cameronhotchkies/Sputterizer/README.md

# Sputterizer
Signal Generator for Eurorack Synthesizers
https://www.greenfacelabs.com/
