cameronhotchkies/Sputterizer/main_board/Bom_DK.xlsx

Manufacturer Part Number | Manufacturer | Digi-Key Part Number | Customer Reference | Reference Designator | Packaging | Part Status | Quantity | Unit Price | Extended Price | Quantity Available | Mfg Std Lead Time | Description | RoHS Status | Lead Free Status | REACH Status
A000005 | Arduino | 1050-1001-ND |  | A1 | Box | Active | 1 | 22 | $22.00 | 850 | Not Available | ARDUINO NANO ATMEGA328 EVAL BRD | RoHS Compliant | Lead free | Not Available
SR215C104KAA | AVX Corporation | 478-2472-ND |  | C2 C4 C5 | Bulk | Active | 3 | 0.2 | $0.60 | 35294 | 11 Weeks | CAP CER 0.1UF 50V X7R RADIAL | ROHS3 Compliant | Lead free | REACH Unaffected
25ML100MEFC8X7 | Rubycon | 1189-3982-ND |  | C6 C1 C3 | Bulk | Active | 3 | 0.29 | $0.87 | 6266 | 17 Weeks | CAP ALUM 100UF 20% 25V RADIAL | ROHS3 Compliant | Lead free | REACH Unaffected
R82EC2100DQ50J | KEMET | 399-5450-1-ND |  | C7 | Cut Tape (CT) | Active | 1 | 0.27 | $0.27 | 49575 | Not Available | CAP FILM 10000PF 5% 100VDC RAD | ROHS3 Compliant | Lead free | REACH Unaffected
R82DC3100DQ50J | KEMET | 399-5444-1-ND |  | C9 C8 | Cut Tape (CT) | Active | 2 | 0.31 | $0.62 | 86862 | Not Available | CAP FILM 0.1UF 5% 63VDC RADIAL | ROHS3 Compliant | Lead free | REACH Unaffected
1N4148-TP | Micro Commercial Co | 1N4148-TPMSCT-ND |  | D1 D2 D3 D4 | Cut Tape (CT) | Active | 4 | 0.1 | $0.40 | 127158 | 14 Weeks | DIODE GEN PURP 75V 150MA DO35 | ROHS3 Compliant | Lead free | REACH Unaffected
1N4148-TP | Micro Commercial Co | 1N4148-TPMSCT-ND |  | D6 D5 | Cut Tape (CT) | Active | 2 | 0.1 | $0.20 | 127158 | 14 Weeks | DIODE GEN PURP 75V 150MA DO35 | ROHS3 Compliant | Lead free | REACH Unaffected
151031SS04000 | Wurth Electronics Inc. | 732-5005-ND |  | D7 | Bulk | Active | 1 | 0.17 | $0.17 | 145 | 11 Weeks | LED RED DIFFUSED 3MM ROUND T/H | ROHS3 Compliant | Lead free | REACH Unaffected
SJ1-3535 | CUI Devices | CP1-3535-ND |  | J1 J2 J3 | Tray | Active | 3 | 1.62 | $4.86 | 3436 | 6 Weeks | CONN JACK STEREO 3.5MM R/A | RoHS Compliant | Lead free | Not Available
PRPC008DAAN-RC | Sullins Connector Solutions | S2011EC-08-ND |  | J4 | Bag | Active | 1 | 0.46 | $0.46 | 976 | Not Available | CONN HEADER VERT 16POS 2.54MM | ROHS3 Compliant | Lead free | REACH Unaffected
67997-210HLF | Amphenol ICC (FCI) | 609-3236-ND |  | J5 | Bag | Active | 1 | 0.54 | $0.54 | 3868 | 7 Weeks | CONN HEADER VERT 10POS 2.54MM | RoHS Compliant | Lead free | Not Available
M20-9990245 | Harwin Inc. | 952-2261-ND |  | JP1 JP2 JP3 | Bulk | Active | 3 | 0.15 | $0.45 | 36078 | 10 Weeks | CONN HEADER VERT 2POS 2.54MM | ROHS3 Compliant | Lead free | REACH Unaffected
BS170-D75Z | ON Semiconductor | BS170-D75ZCT-ND |  | Q1 | Cut Tape (CT) | Active | 1 | 0.4 | $0.40 | 5612 | 7 Weeks | MOSFET N-CH 60V 500MA TO-92 | ROHS3 Compliant | Lead free | REACH Unaffected
CF14JT470R | Stackpole Electronics Inc | CF14JT470RCT-ND |  | R1 | Cut Tape (CT) | Active | 1 | 0.1 | $0.10 | 174664 | 15 Weeks | RES 470 OHM 1/4W 5% AXIAL | ROHS3 Compliant | Lead free | REACH Unaffected
MRS25000C1002FCT00 | Vishay BC Components | BC3326CT-ND |  | R10 R9 | Cut Tape (CT) | Active | 2 | 0.29 | $0.58 | 6522 | 14 Weeks | RES 10K OHM 0.6W 1% AXIAL | ROHS3 Compliant | Lead free | Not Available
CF14JT470R | Stackpole Electronics Inc | CF14JT470RCT-ND |  | R2 R3 | Cut Tape (CT) | Active | 2 | 0.1 | $0.20 | 174664 | 15 Weeks | RES 470 OHM 1/4W 5% AXIAL | ROHS3 Compliant | Lead free | REACH Unaffected
MRS25000C1782FCT00 | Vishay BC Components | BC4022CT-ND |  | R4 | Cut Tape (CT) | Discontinued at Digi-Key | 1 | 0.29 | $0.29 | 4129 | Not Available | RES 17.8K OHM 0.6W 1% AXIAL | ROHS3 Compliant | Lead free | Not Available
MRS25000C1403FCT00 | Vishay BC Components | BC3995CT-ND |  | R5 | Cut Tape (CT) | Active | 1 | 0.29 | $0.29 | 3344 | 14 Weeks | RES 140K OHM 0.6W 1% AXIAL | ROHS3 Compliant | Lead free | Not Available
MRS25000C1582FCT00 | Vishay BC Components | BC4574CT-ND |  | R6 | Cut Tape (CT) | Active | 1 | 0.29 | $0.29 | 3644 | 14 Weeks | RES 15.8K OHM 1% 0.6W AXIAL | ROHS3 Compliant | Lead free | Not Available
CF14JT1K00 | Stackpole Electronics Inc | CF14JT1K00CT-ND |  | R7 | Cut Tape (CT) | Active | 1 | 0.1 | $0.10 | 634886 | 15 Weeks | RES 1K OHM 1/4W 5% AXIAL | ROHS3 Compliant | Lead free | REACH Unaffected
CF14JT10K0 | Stackpole Electronics Inc | CF14JT10K0CT-ND |  | R8 | Cut Tape (CT) | Active | 1 | 0.1 | $0.10 | 522197 | 15 Weeks | RES 10K OHM 1/4W 5% AXIAL | ROHS3 Compliant | Lead free | REACH Unaffected
PTD901-1015K-B103 | Bourns Inc. | PTD901-1015K-B103-ND |  | RV1 RV2 RV3 | Tray | Active | 3 | 1.68 | $5.04 | 1041 | 15 Weeks | POT 10K OHM 1/20W CARBON LINEAR | ROHS3 Compliant | Lead free | REACH Unaffected
5006 | Keystone Electronics | 36-5006-ND |  | TP1 | Bulk | Active | 1 | 0.35 | $0.35 | 108660 | 6 Weeks | PC TEST POINT COMPACT BLACK | ROHS3 Compliant | Lead free | REACH Unaffected
SA5532AP | Texas Instruments | 296-16995-5-ND |  | U1 U2 | Tube | Active | 2 | 0.94 | $1.88 | 392 | 6 Weeks | IC OPAMP GP 2 CIRCUIT 8DIP | ROHS3 Compliant | Lead free | REACH Unaffected
CD4013BE | Texas Instruments | 296-2033-5-ND |  | U3 | Tube | Active | 1 | 0.5 | $0.50 | 41960 | 6 Weeks | IC FF D-TYPE DUAL 1BIT 14DIP | ROHS3 Compliant | Lead free | REACH Unaffected
MC78L05BP-AP | Micro Commercial Co | MC78L05BP-APMSCT-ND |  | U4 | Cut Tape (CT) | Active | 1 | 0.42 | $0.42 | 8264 | 14 Weeks | IC REG LINEAR 5V 100MA TO92 | ROHS3 Compliant | Lead free | REACH Unaffected
AR 08 HZL-TT | Assmann WSW Components | AE10011-ND |  | K1 K2 | Tube | Active | 2 | 0.5 | $1.00 | 29133 | 20 Weeks | CONN IC DIP SOCKET 8POS TIN | ROHS3 Compliant | Lead free | REACH Unaffected
AR 14 HZL-TT | Assmann WSW Components | AE10012-ND |  | K3 | Tube | Active | 1 | 0.79 | $0.79 | 3516 | 20 Weeks | CONN IC DIP SOCKET 14POS TIN | ROHS3 Compliant | Lead free | REACH Unaffected
