cameronhotchkies/Sputterizer/main_board/Bom_mouser.xlsx

Manufacturer Part Number | Manufacturer | Customer Reference | Reference Designator | Quantity | Digi-Key Part Number
A000005 | Arduino | Arduino_Nano_v3.x | A1 | 1 | 1050-1001-ND
SR215C104KAA | AVX Corporation | 100nF | C2 C4 C5 | 3
EKRG350ELL101MH09D | United Chemi-Con (UCC) | 100uF | C6 C1 C3 | 3 | 1189-3982-ND
R82EC2100DQ50J | KEMET | 10nF | C7 | 1
R82DC3100DQ50J | KEMET | 100nF | C9 C8 | 2
SB120-T | Diodes Incorporated | SB120 | D1 D2 D3 D4 | 4
1N4448 | ON Semiconductor | 1N4448 | D5 D6 | 2
151031VS06000 | Wurth Electronics Inc. | GREEN LED | D7 | 1
SJ1-3535 | CUI Devices | SJ1-3535 | J1 J2 J3 | 3
649-77313-418-16LF | Amphenol ICC (FCI) | 2X8 Header | J4 | 1
67997-210HLF | Amphenol ICC (FCI) | Conn_02x05_Odd_Even | J5 | 1
M20-9990245 | Harwin Inc. | Conn_01x02_Male | JP1 JP2 JP3 | 3
BS170-D75Z | ON Semiconductor | BS170 | Q1 | 1
CFR-25JR-52-10K | Yaego | 10K | R1 | 1
MRS25000C1002FCT00 | Vishay BC Components | 10.0K | R10 R9 | 2
CFR-25JT-52-470R | Yaego | 470 | R2 R3 | 2
MFR-25FBF52-17K8 | Yaego | 17.8K | R4 | 1
MRS25000C1403FCT00 | Vishay BC Components | 140K | R5 | 1
MFR-25FBF52-15K8 | Yaego | 15.8K | R6 | 1
CFR-25JB-1K0 | Yaego | 1K | R7 | 1
CFR-25JT-52-20K | Yaego | 20K | R8 | 1
PTD901-1015K-B103 | Bourns Inc. | 10K | RV1 RV2 RV3 | 3
5006 | Keystone Electronics | TestPoint | TP1 | 1 | 36-5006-ND
SA5532AP | Texas Instruments | NE5532 | U1 U2 | 2
CD4013BE | Texas Instruments | CD4013BE | U3 | 1
MC78L05BP-AP | Micro Commercial Co | L78L05_TO92 | U4 | 1
110-47-308-41-001000 | Mill-Max | CONN IC DIP SOCKET 8POS TIN | K1 K2 | 2
110-47-314-41-001000 | Mill-Max | CONN IC DIP SOCKET 14POS TIN | K3 | 1
K103M15X7RF53L2 | Vishay BC Components | .01uF | SC1 SC2 | 2
ECE-A1EKA470I | Panasonic Electronic Components | 47uF | SC4 | 1
SR215C104KAA | AVX Corporation | .1uF | SC5 SC3 | 2
151031SS04000 | Wurth Electronics Inc. | Red LED | SD1 SD2 SD3 SD4 SD5 SD6 SD7 SD8 SD9 SD10 SD11 SD12 | 12
67997-210HLF | Amphenol ICC (FCI) | Conn_02x05_Odd_Even | SJ1 | 1
CFR-25JB-1K0 | Yaego | 1K | SR7 | 1
CFR-25JR-52-10K | Yaego | 10K | SR3 SR5 SR1 SR2 | 4
CFR-25JT-52-2K2 | Yaego | 2.2K | SR4 SR6 | 2
PEC11R-4315F-S0012 | Bourns Inc. | PEC11R | SSW1 | 1
TLC5916IN | Texas Instruments | TLC5916 | SU1 SU2 | 2
110-47-316-41-001000 | Mill-Max | CONN IC DIP SOCKET 16POS TIN | SK1 SK2 | 2
IDSD-05-D-03.00-T | Samtec | Cable | SCB1 | 1
HCSD-08-D-12.00-01-N-G | Samtec | 16 Pos Cable | SCB2
971070155 | Wurth Electronics Inc. |  | SA1 SA2 SA3 SA4 | 4
4687 | Keystone Electronics |  | SB1 SB2 SB3 SB4 | 4
29331 | Keystone Electronics |  | SC1 SC2 SC3 SC4 | 4
705820060 | Wurth Electronics Inc. | LED Standoff 6mm | SL1 SL2 SL3 SL4 SL5 SL6 SL7 SL8 SL9 SL10 SL11 SL12 | 12
1221-L | Davies Moulding | Knob | KN1 KN2 KN3 KN4 | 4
450-CK1560 | Eagle Plastic Devices | Knob | KN5 | 1
