cameronhotchkies/Sputterizer/main_board/sputterizer.xlsx

Reference | Quantity | Value | Digi-Key Part
A1 | 1 | Arduino_Nano_v3.x | 1050-1001-ND
C2 C4 C5 | 3 | 100nF | 478-2472-ND
C6 C1 C3 | 3 | 100uF | 1189-3982-ND
C7 | 1 | 10nF | 399-5450-1-ND
C9 C8 | 2 | 100nF | 399-5444-1-ND
D1 D2 D3 D4 | 4 | SB120 | 1N4148-TPMSCT-ND
D5 D6 | 2 | 1N4148 | 1N4148VSCT-ND
D7 | 1 | LED | 732-5005-ND
J1 J2 J3 | 3 | SJ1-3535 | CP1-3535-ND
J4 | 1 | 2X8 Header | S2011EC-08-ND
J5 | 1 | Conn_02x05_Odd_Even | 609-3236-ND
JP1 JP2 JP3 | 3 | Conn_01x02_Male | 952-2261-ND
Q1 | 1 | BS170 | BS170-D75ZCT-ND
R1 | 1 | 10K | CF14JT10K0CT-ND
R10 R9 | 2 | 10.0K | BC3326CT-ND
R2 R3 | 2 | 470 | CF14JT470RCT-ND
R4 | 1 | 17.8K | PPC17.8KXCT-ND
R5 | 1 | 140K | BC3995CT-ND
R6 | 1 | 15.8K | BC4574CT-ND
R7 | 1 | 1K | CF14JT1K00CT-ND
R8 | 1 | 20K | CF14JT20K0CT-ND
RV1 RV2 RV3 | 3 | 10K | PTD901-1015K-B103-ND
TP1 | 1 | TestPoint | 36-5006-ND
U1 U2 | 2 | NE5532 | 296-16995-5-ND
U3 | 1 | CD4013BE | 296-2033-5-ND
U4 | 1 | L78L05_TO92 | MC78L05BP-APMSCT-ND
K1 K2 | 2 | CONN IC DIP SOCKET 8POS TIN | AE10011-ND
K3 | 1 | CONN IC DIP SOCKET 14POS TIN | AE10012-ND
SC1 SC2 | 2 | .01uF | BC5136-ND
SC4 | 1 | 47uF | P19582CT-ND
SC5 SC3 | 2 | .1uF | 478-2472-ND
SD1 SD2 SD3 SD4 SD5 SD6 SD7 SD8 SD9 SD10 SD11 SD12 | 12 | Red LED | 732-5005-ND
SJ1 | 1 | Conn_02x05_Odd_Even | 609-3236-ND
SR3 SR5 SR1 SR2 | 4 | 10K | CF14JT10K0CT-ND
SR4 SR6 | 2 | 2K | CF14JT2K20CT-ND
SSW1 | 1 | PEC11R | PEC11R-4315F-S0012-ND
SU1 SU2 | 2 | TLC5916 | 296-24383-5-ND
SCB1 | 1 | Cable | 3M156030-MC10G-3M156030-3-ND
SA1 SA2 SA3 SA4 | 4 |  | 732-13045-ND
SB1 SB2 SB3 SB4 | 4 |  | 36-4687-ND
SC1 SC2 SC3 SC4 | 4 |  | 36-29331-ND
SL1 SL2 SL3 SL4 SL5 SL6 SL7 SL8 SL9 SL10 SL11 SL12 | 12 |  | RPC4260-ND
SK1 | 1 | Knob | 226-4215-ND
