cameronhotchkies/Sputterizer/main_board/sputterizer/schematic.pdf

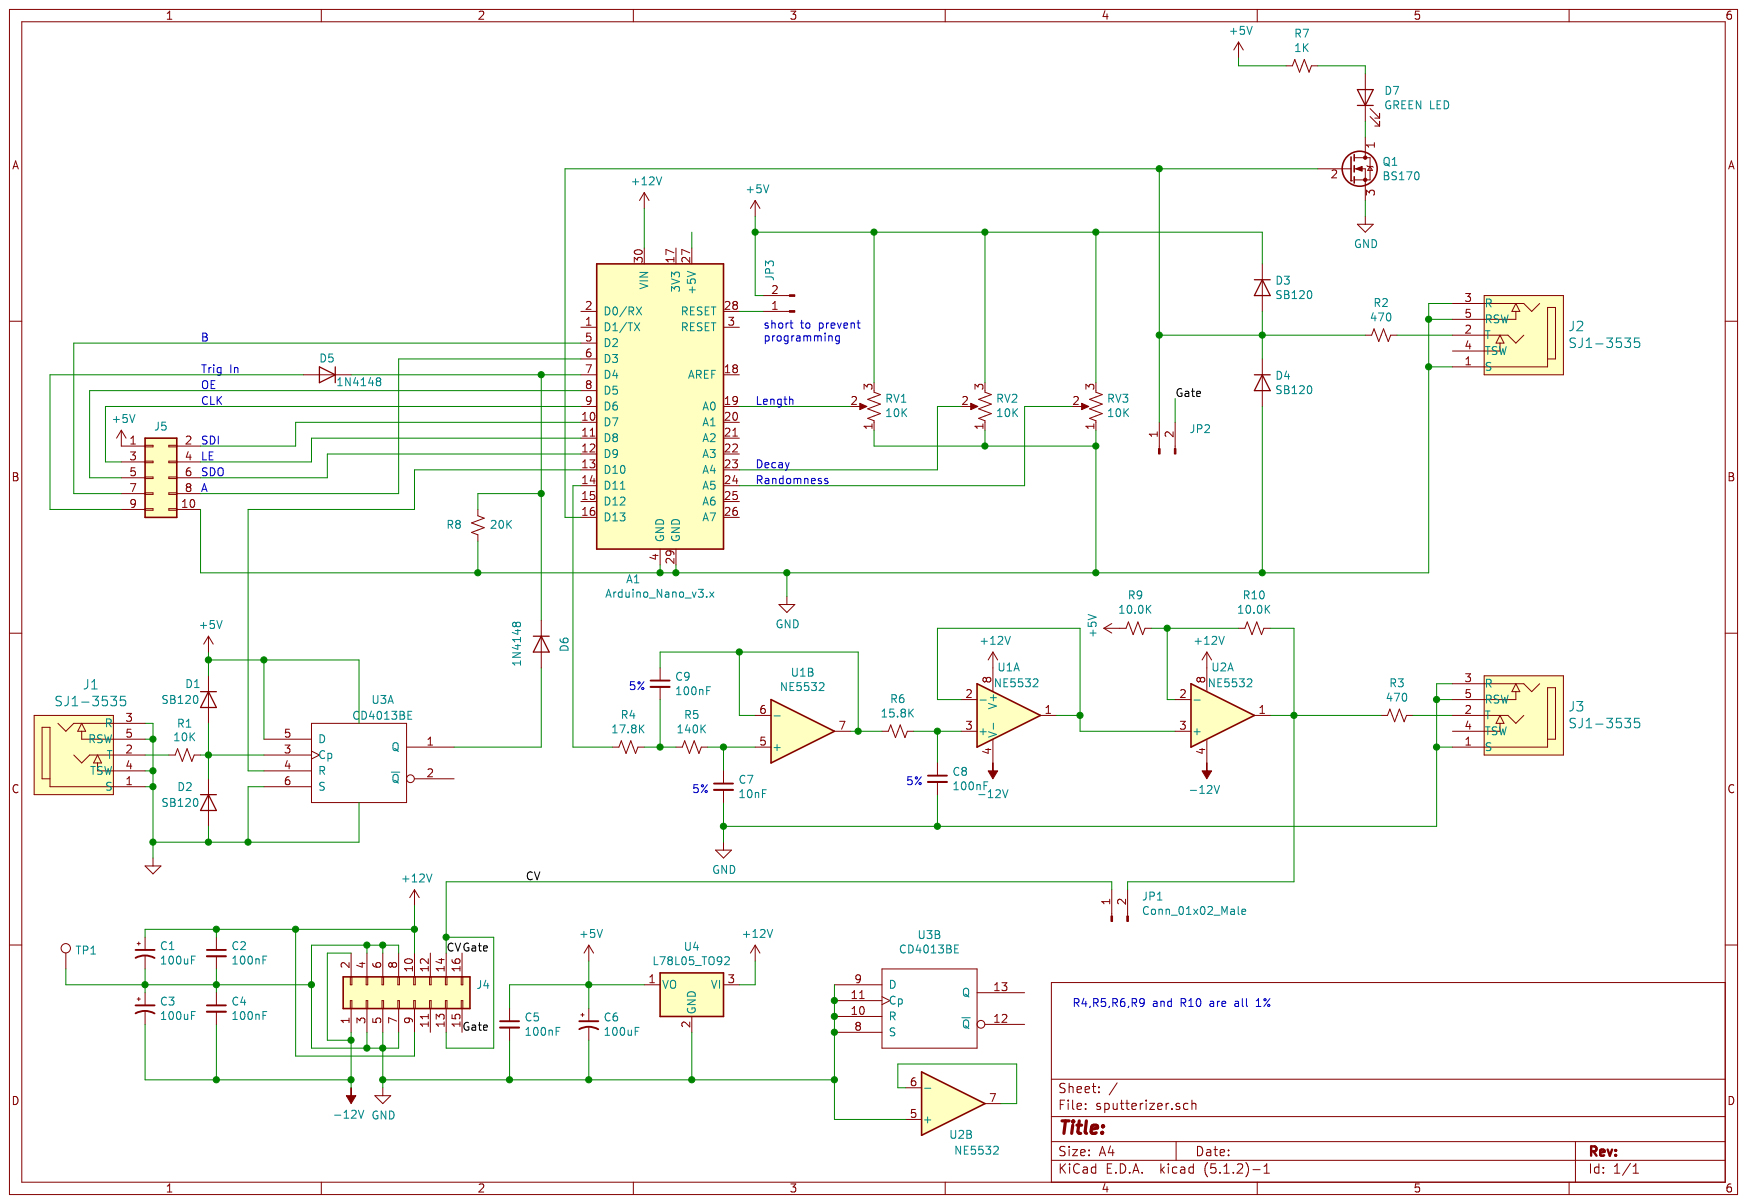
[picture p1: page 1]
