cameronhotchkies/Sputterizer/spice/comparator_flip_flop.asc

C1: cap; 1µF; V=100 Irms=3.01 Rser=0.0355863 Lser=0
C2: cap; 1µF; V=100 Irms=3.01 Rser=0.0355863 Lser=0
C3: cap; .22µF; V=100 Irms=0 Rser=0 Lser=0
C4: cap; 1µF; V=100 Irms=3.01 Rser=0.0355863 Lser=0
C5: cap; 1µF; V=100 Irms=3.01 Rser=0.0355863 Lser=0
D1: zener; BZX84C6V2L
D2: diode; 1N4148
D3: diode; 1N914
D4: diode; 1N4148
R1: res; 470; tol=1 pwr=0.1
R2: res; 470; tol=1
R3: res; 470; tol=1 pwr=.25
R4: res; 200k; tol=1 pwr=0.1
R5: res; 10K; tol=1 pwr=0.1
R6: res; 10k; tol=1 pwr=0.1
R7: res; 10K; tol=1 pwr=0.1
R8: res; 10K; tol=1 pwr=0.1
R9: res; 20K
R10: res; 1k; tol=1 pwr=0.1
R11: res; 1k; tol=1 pwr=0.1
U1a: LT1352
V1: signal; PULSE(0 5 .2 .0001 .0001 .005 .5 2); AC 1
V2: voltage; 12
V3: voltage; 12
V4: signal; PULSE(0 5 .5 .0001 .0001 .001 0 1); AC 1
V5: signal; SINE(0 .3 1000 .0001 .0001 .001 0); AC 1
V6: signal; SINE(0 .3 1008 .0003 .0001 .001 0); AC 1
Named nets: 0, Output, -12v, +12V, Reset, Trigger
;ac dec 100 1 100
;op 0 1 .1 .01
.tran 0 1 .1 .01
Trigger
Reset
