cameronhotchkies/Sputterizer/main_board/sputterizer/sputterizer.kicad_pcb

## KiCad design main_board/sputterizer/sputterizer.kicad_pcb (2020-03-03)

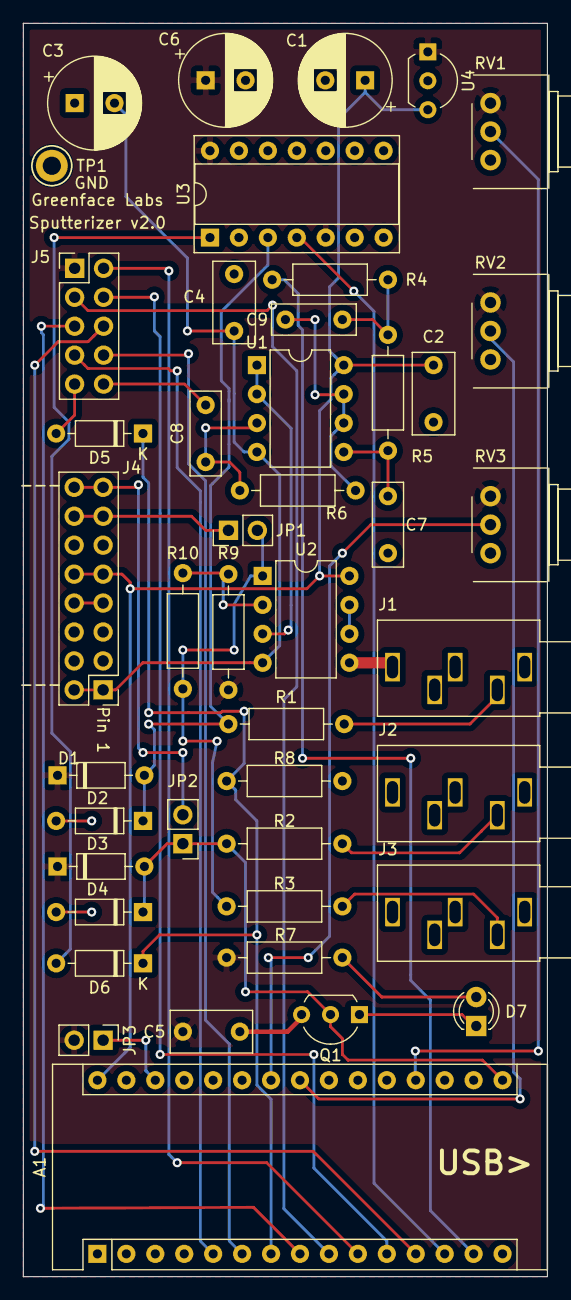
[picture p2: board sputterizer.kicad_pcb from above]

Board: 2 copper layers, 46.0 x 110.0 mm, 44 parts (0 on the bottom side), 37 nets.

Parts:
A1: Arduino_Nano_v3.x; Arduino_Nano
C1, C3, C6: 100uF; CP_Radial_D8.0mm_P3.50mm
C2, C4, C5: 100nF; C_Rect_L7.0mm_W3.5mm_P5.00mm
C7: 10nF; C_Rect_L7.2mm_W2.5mm_P5.00mm_FKS2_FKP2_MKS2_MKP2
C8, C9: 100nF; C_Rect_L7.2mm_W2.5mm_P5.00mm_FKS2_FKP2_MKS2_MKP2
D1, D2, D3, D4: SB120; D_DO-35_SOD27_P7.62mm_Horizontal
D5, D6: 1N4148; D_DO-35_SOD27_P7.62mm_Horizontal
D7: LED; LED_D3.0mm
J1, J2, J3: SJ1-3535; Jack_3.5mm_CUI_SJ1-3535NG_Horizontal_RectangularHoles
J4: 2X8 Header; PinHeader_2x08_P2.54mm_Vertical
J5: Conn_02x05_Odd_Even; PinHeader_2x05_P2.54mm_Vertical
JP1, JP2, JP3: Conn_01x02_Male; PinHeader_1x02_P2.54mm_Vertical
Q1: BS170; TO-92L_Inline_Wide
R1: 10K; R_Axial_DIN0207_L6.3mm_D2.5mm_P10.16mm_Horizontal
R2, R3: 470; R_Axial_DIN0207_L6.3mm_D2.5mm_P10.16mm_Horizontal
R4: 17.8K; R_Axial_DIN0207_L6.3mm_D2.5mm_P10.16mm_Horizontal
R5: 140K; R_Axial_DIN0207_L6.3mm_D2.5mm_P10.16mm_Horizontal
R6: 15.8K; R_Axial_DIN0207_L6.3mm_D2.5mm_P10.16mm_Horizontal
R7: 1K; R_Axial_DIN0207_L6.3mm_D2.5mm_P10.16mm_Horizontal
R8: 20K; R_Axial_DIN0207_L6.3mm_D2.5mm_P10.16mm_Horizontal
R9, R10: 10.0K; R_Axial_DIN0207_L6.3mm_D2.5mm_P10.16mm_Horizontal
RV1, RV2, RV3: 10K; Potentiometer_Bourns_PTD901_Single_Horizontal
TP1: TestPoint; TestPoint_Keystone_5005-5009_Compact
U1, U2: NE5532; DIP-8_W7.62mm
U3: CD4013BE; DIP-14_W7.62mm_Socket
U4: L78L05_TO92; TO-92L_Inline_Wide

Connections:
+5V: C5.1, C6.1, D1.1, D3.1, J5.1, JP3.2, R7.2, R9.1, RV1.3, RV2.3, RV3.3, U3.5, U3.14, U4.1
+12V: A1.30, C1.1, C2.1, J4.9, J4.10, U1.8, U2.8, U4.3
-12V: C3.2, C4.2, J4.1, J4.2, U1.4, U2.4
/CV: J4.13, J4.14, JP1.1
/Gate: J4.15, J4.16, JP2.2
GND: A1.4, A1.29, C1.2, C2.2, C3.1, C4.1, C5.2, C6.2, C7.2, C8.2, D2.2, D4.2, J1.1, J1.3, J1.4, J1.5, J2.1, J2.3, J2.5, J3.1, J3.3, J3.5, J4.3, J4.4, J4.5, J4.6, J4.7, J4.8, J5.10, Q1.3, R8.1, RV1.1, RV2.1, RV3.1, TP1.1, U2.5, U3.6, U3.7, U3.8, U3.9, U3.10, U3.11, U4.2
unnamed: A1.5, J5.7
unnamed: A1.6, J5.8
unnamed: A1.7, D5.1, D6.1, R8.2
unnamed: A1.8, J5.5
unnamed: A1.9, J5.3
unnamed: A1.10, J5.2
unnamed: A1.11, J5.4
unnamed: A1.12, J5.6
unnamed: A1.13, U3.4
unnamed: A1.14, R4.2
unnamed: A1.16, D3.2, D4.1, JP2.1, Q1.2, R2.2
unnamed: A1.19, RV1.2
unnamed: A1.23, RV2.2
unnamed: A1.24, RV3.2
unnamed: A1.28, JP3.1
unnamed: C7.1, R5.1, U1.5
unnamed: C8.1, R6.1, U1.3
unnamed: C9.1, R6.2, U1.6, U1.7
unnamed: C9.2, R4.1, R5.2
unnamed: D1.2, D2.1, R1.1, U3.3
unnamed: D5.2, J5.9
unnamed: D6.2, U3.1
unnamed: D7.1, Q1.1
unnamed: D7.2, R7.1
unnamed: J1.2, R1.2
unnamed: J2.2, R2.1
unnamed: J3.2, R3.1
unnamed: JP1.2, R3.2, R10.2, U2.1
unnamed: R9.2, R10.1, U2.2
unnamed: U1.1, U1.2, U2.3
unnamed: U2.6, U2.7
