cameronhotchkies/Sputterizer/(commit log)

2019-06-02 Create Sputterizer Repository
    [sputterer.kicad_pcb, sputterer.sch]
2019-06-02 Adds files
    [sputterer-B_Cu.gbr, sputterer-B_Mask.gbr, sputterer-B_Paste.gbr, sputterer-B_SilkS.gbr, sputterer-Edge_Cuts.gbr, sputterer-F_Cu.gbr, sputterer-F_Mask.gbr, sputterer-F_Paste.gbr]
2019-06-03 Adds Front Panel
    [panel-B_Cu.gbr, panel-B_Mask.gbr, panel-B_Paste.gbr, panel-B_SilkS.gbr, panel-Edge_Cuts.gbr, panel-F_Cu.gbr, panel-F_Mask.gbr, panel-F_Paste.gbr]
2019-06-04 Latest changes.
    [panel-B_Cu.gbr, panel-B_Mask.gbr, panel-B_Paste.gbr, panel-B_SilkS.gbr, panel-Edge_Cuts.gbr, panel-F_Cu.gbr, panel-F_Mask.gbr, panel-F_Paste.gbr]
2019-06-04 Gerber File
2019-06-11 Changes to code and adds drill to gerber
    [sputterer-B_Cu.gbr, sputterer-B_Fab.gbr, sputterer-B_Mask.gbr, sputterer-B_Paste.gbr, sputterer-Edge_Cuts.gbr, sputterer-F_Cu.gbr, sputterer-F_Fab.gbr, sputterer-F_Mask.gbr]
2019-06-17 Changes to board and code
    [panel-B_Cu.gbr, panel-B_Mask.gbr, panel-B_Paste.gbr, panel-B_SilkS.gbr, panel-Edge_Cuts.gbr, panel-F_Cu.gbr, panel-F_Mask.gbr, panel-F_Paste.gbr]
2019-06-25 New design and code.
    [panel-B_Cu.gbr, panel-B_Mask.gbr, panel-B_Paste.gbr, panel-B_SilkS.gbr, panel-Edge_Cuts.gbr, panel-F_Cu.gbr, panel-F_Mask.gbr, panel-F_Paste.gbr]
2019-07-06 New code and BOM
    [sputterizer.csv, sputterizer.xlsx]
2019-09-01 Safety Checkin
    [sputterer.sch]
2020-03-03 Latest checkin
    [Bom_DK.xlsx, Bom_mouser.xlsx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]
